Abdulaziz-kh-Hatem/eog-acquisition-platform/(commit log)

2026-09-14 feat: add comprehensive documentation with signal quality evidence for published EOG platform
    - Added README with full system architecture, specifications, and citation
    - Added oscilloscope captures showing 50Hz interference before filtering
    - Added MATLAB signal quality plots (noise comparison, filtered EOG, blink detection)
    - Added hardware photos (circuit schematic, AD620, full test setup)
    - This platform is the hardware foundation for the eog-assistive-hci-keyboard project
    - Published in EEA Journal 2026 (DOI: 10.46904/eea.26.74.2.1108016)
2026-09-17 feat(acquisition): add clean Arduino 250Hz firmware and MATLAB DSP pipeline
    - Implement non-blocking 250Hz Arduino ADC acquisition firmware (src/arduino/)
    - Implement real-time MATLAB acquisition, DSP filtering, thresholding & HMI (src/matlab/eog_realtime_acquisition.m)
    - Implement quantitative statistical analysis script reproducing Table 1 & Figures 11-15 (src/matlab/eog_signal_analysis.m)
    - Add automated unit test suite verifying DSP filter response and event logic (tests/test_eog_pipeline.m)
    - Update README.md with software architecture, 250Hz specifications, and repo structure
2026-09-17 fix: integrate wheelchair firmware, robust hardware cleanup, and dynamic FSM verification
    [wheelchair_controller.ino]
